Harm-Paas/PA0HPG_Rotator/Docs/Rotor_and_Control.jpg

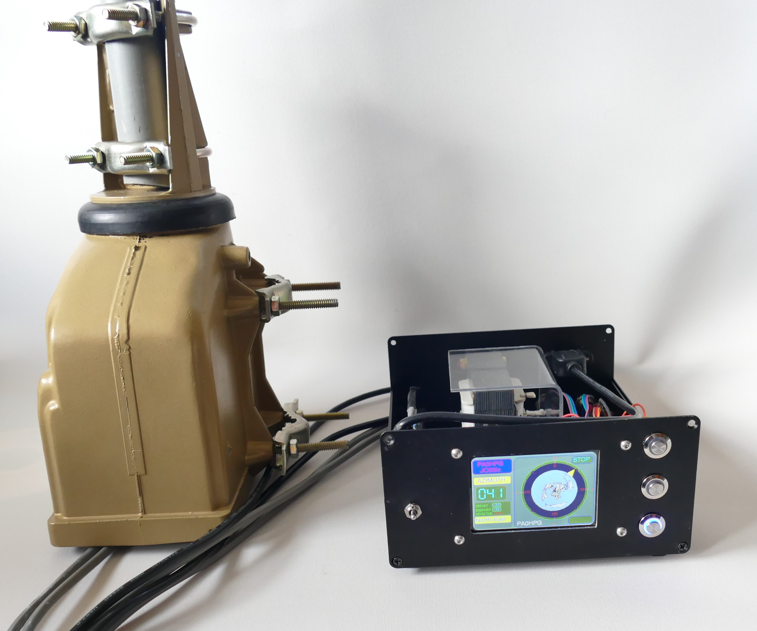
Docs/Rotor_and_Control.jpg
