Harm-Paas/PA0HPG_Rotator/Docs/Display_En.jpg

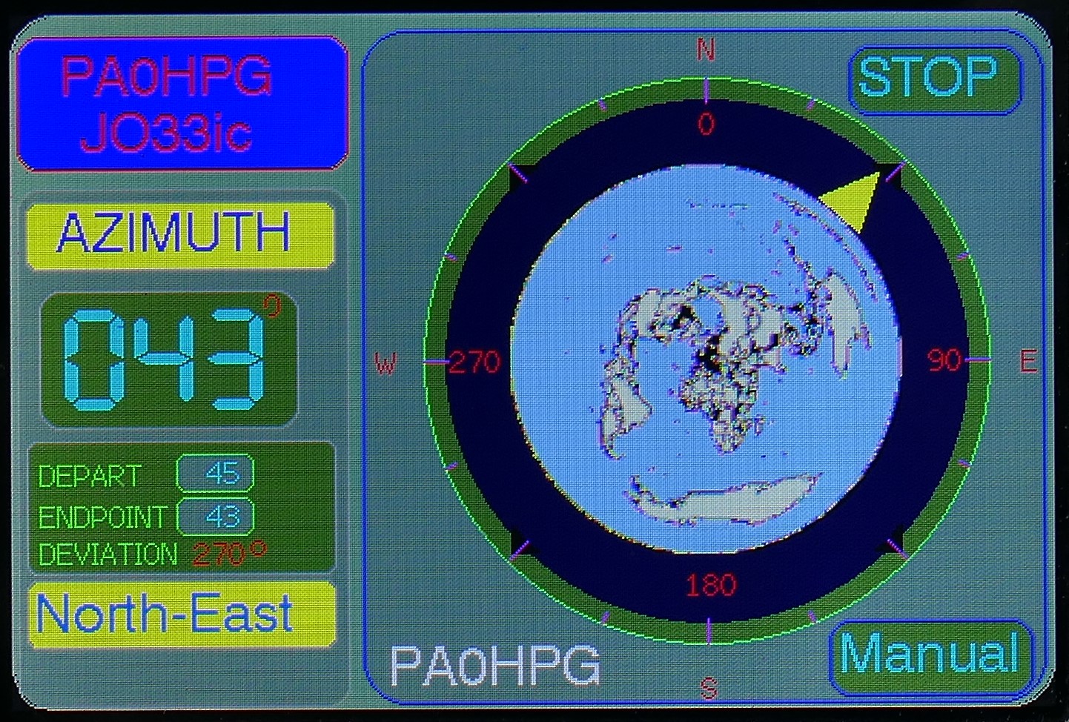
Docs/Display_En.jpg
