Harm-Paas/PA0HPG_Rotator/Docs/Kast_Controller_Bodem.pdf

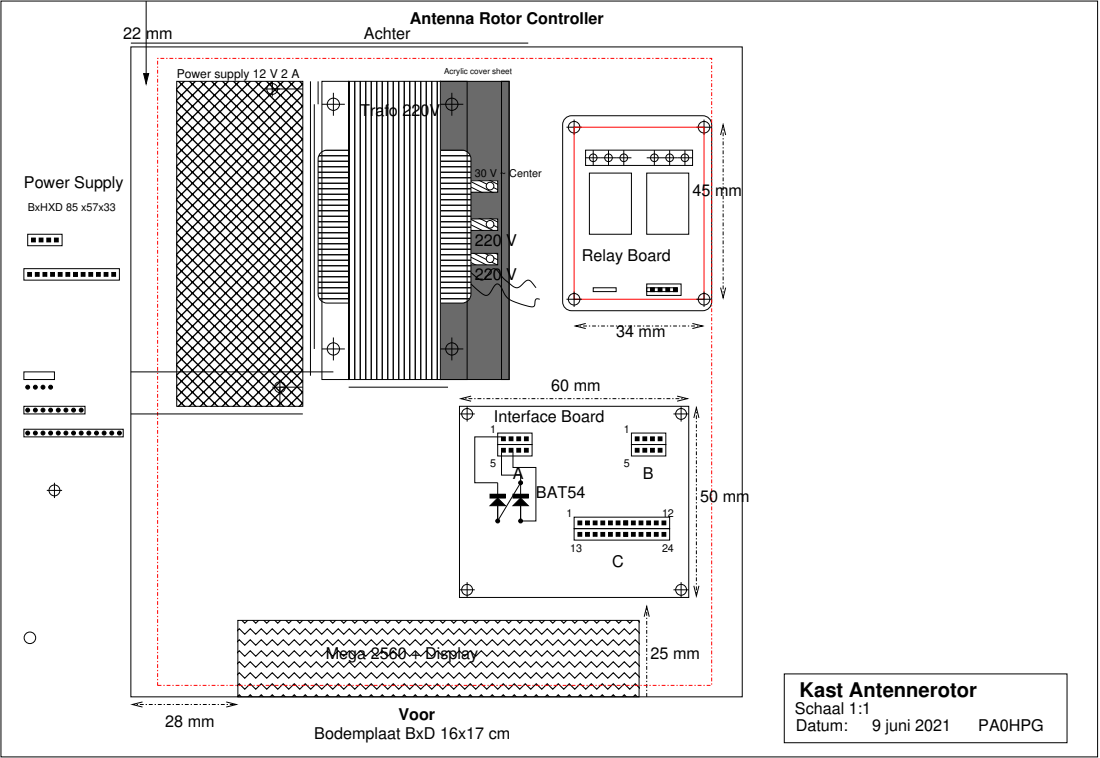
[picture p3: page 1]
Interface Board; Power supply 12 V 2 A; Relay Board; Schaal 1:1 Datum:; Kast Antennerotor; Voor; Power Supply; BxHXD 85 x57x33; Mega 2560 + Display; 9 juni 2021; PA0HPG; BAT54; 30 V ~ Center; Trafo 220V

Antenna Rotor Controller
Achter

Acrylic cover sheet

Bodemplaat BxD 16x17 cm 28 mm
