Harm-Paas/PA0HPG_Rotator/Docs/Kast_Controller_Voor-Achter.pdf

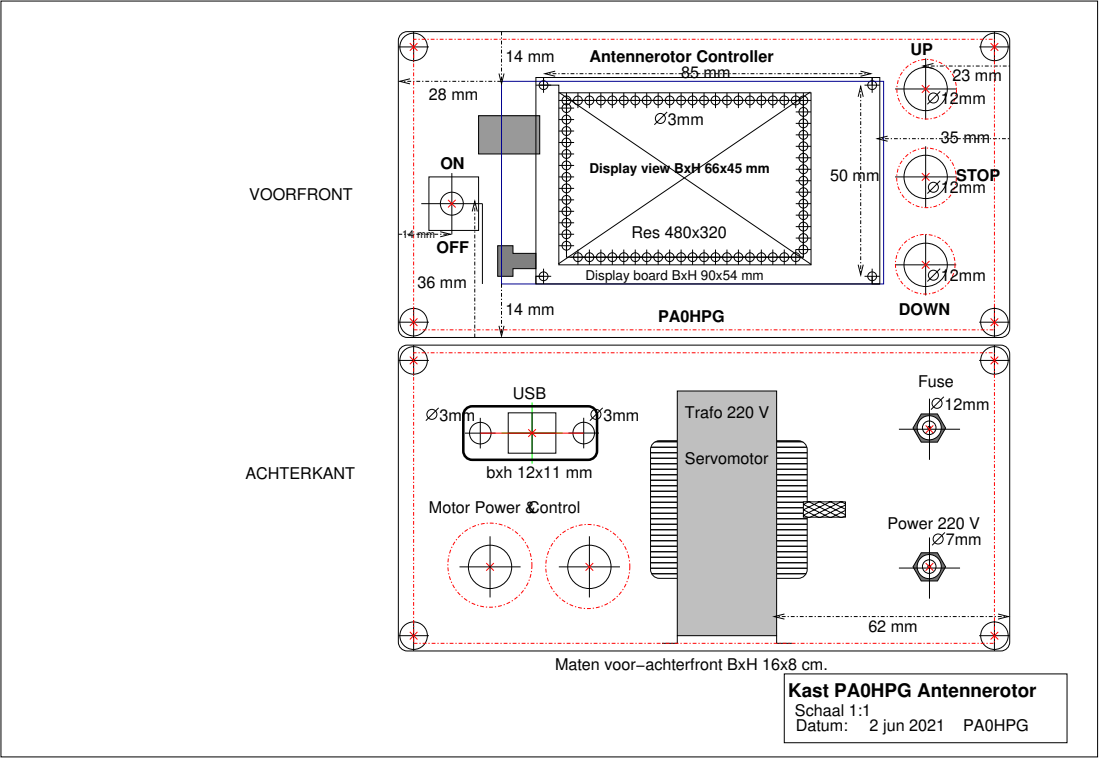
[picture p4: page 1]
Trafo 220 V; OFF; USB; bxh 12x11 mm; Schaal 1:1 Datum:; Antennerotor Controller; ACHTERKANT; VOORFRONT; Power 220 V; Fuse; PA0HPG; 2 jun 2021 PA0HPG; Kast PA0HPG Antennerotor; Servomotor; STOP; DOWN; Res 480x320

Display view BxH 66x45 mm

Display board BxH 90x54 mm

Control Motor Power &

Maten voor−achterfront BxH 16x8 cm.
