Harm-Paas/PA0HPG_Rotator/Docs/PA0HPG_AntenneRotor_schem.pdf

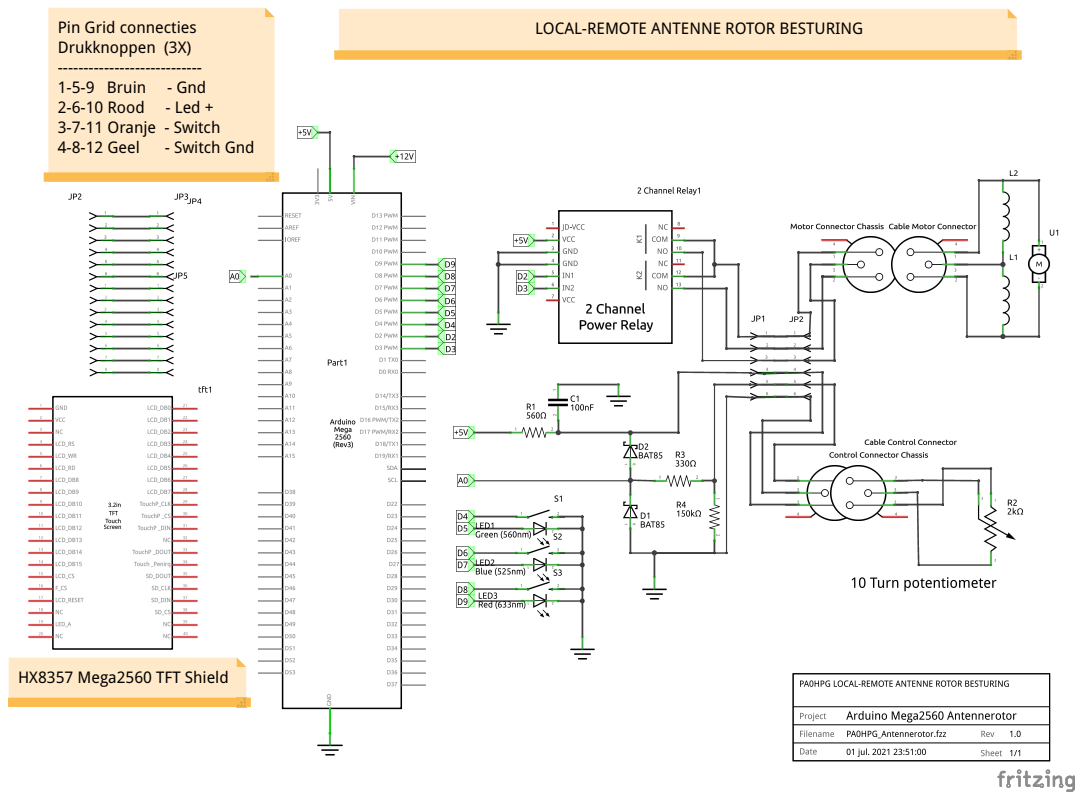
[picture p5: page 1]
4-8-12 Geel; - Switch Gnd; HX8357 Mega2560 TFT Shield

Pin Grid connecties
Drukknoppen (3X)
1-5-9 Bruin - Gnd
2-6-10 Rood - Led +
3-7-11 Oranje - Switch

LOCAL-REMOTE ANTENNE ROTOR BESTURING
