Harm-Paas/PA0HPG_Rotator/(notices)

Notices in the files:
PA0HPG_Antennarotor.ino:
This program is free software: you can redistribute it and/or modify
it under the terms of the GNU General Public License as published by
the Free Software Foundation, either version 3 of the License, or
any later version.
Switch.ino:
Copyright (C) 2012 Albert van Dalen http://www.avdweb.nl
This program is free software: you can redistribute it and/or modify it under the terms of the GNU General Public License
